voroshkov/Solo-DIY-RF-Laptimer/(threads)

Thread 4 (2017-01-16):

Question

Freakshowdevil, 2017-01-16:
A quick question, Is it possible to have all the channels selectable via the app, is it a Arduino limitation or is the code not complete?
Nice work man :1st_place_medal:  ordering all part now and looking forward to the Multi-tracking Laptimer solution. How far have you come? How many RX5808 should I order :) and are you using Arduino Pro Mini for this one as well?

voroshkov, 2017-01-16:
Yes, it's possible to make all bands/channels selectable. I intentionally limited them to simplify the app.

As for the multi-version: it will use the same hardware with minor modifications. My idea is to make the "Solo" devices attachable to each other to track several pilots during a race. Each racer may have his own fully functional device to track his solo flights, but when flying with friends, they just plug their laptimers like **A**->**B**->**C**.. -> **Bluetooth** and use the same hardware & software.
So far the Arduino code for the multi- version is complete and real Android app (not the AppInventor) is capable of communicating via bluetooth :)

voroshkov, 2017-01-16:
So for the multi- solution you need solo- hardware multiplied by the number of devices you'd like to make :)

Freakshowdevil, 2017-01-16:
That is brilliant, I am so excited about this 👍
I'm ordering everything times 3.
Great if all band and channels are selectable, because some of my friends uses vtx that dont have raceband.

Super work, you're a king mate 👑

voroshkov, 2017-01-16:
Thanks for the feedback!

Freakshowdevil, 2017-01-16:
An idea for the start race. When you hitt start on the app the laptimer should wait 10 seconds before it starts tracking, the last 5 seconds of the wait timer the buzzer should beep each second and one long beep when race starts (start countdown).
And another thing is to set max lap count and long buzzer beep when max lap is reached for all quads. Then you don't have to count in your head when flying 😁

Just some ideas

voroshkov, 2017-01-18:
Thanks for the ideas. However they are likely to be implemented in a next generation app :)

Freakshowdevil, 2017-01-26:
Which pin number do you use to connect more RF-Laptimers together, so I can prepare this on my timers that I build.

voroshkov, 2017-01-31:
So far my idea is to make it like this:
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

Thread 5 (2017-01-17):

BaudRate for HC06

jreis1, 2017-01-17:
Just a quick note, it seems that for some HC06 Bluetooth modules the pre defined 115200baud doesn't work.  This value must be altered to 9600baud.

Great job here mate!

voroshkov, 2017-01-17:
I think all HC-06 BT modules may pre-tuned to communicate at 115200 using "AT+BAUD8" command (as seen here, for example: https://www.youtube.com/watch?v=jSxcEZHsV0A).

9600 will slow down the communication and make the Android app less responsive, I guess.

brkdwn, 2017-01-19:
Just fyi I also had to programm the HC-06 to 115200. Now everything is working fine. Thanks for the help.

voroshkov, 2017-01-20:
Updated Readme with simplified BT module setup steps.

Freakshowdevil, 2017-01-22:
Can't get the BT to communicate to Pro mini. In app when connected it only shows S>>> Flashing nothing more? I have the baud rate set to 115200. And one more thing, how do I easily check if my pro-mini is a 5V or 3.3V? I believe that I received the wrong one (3.3V) and that's my problem.

Freakshowdevil, 2017-01-23:
Found the problem, my arduino is 3.3v 8MHz 😪

Thread 6 (2017-01-20):

channels

plastinaf, 2017-01-20:
Hello
Good work and thank you for sharing
I modified the channels.h tab.
To activate the channel and frequency F / Airwave because me and many people don't have raceBand
----------------------------------------------
// Channels to send to the SPI registers
const uint16_t channelTable[] PROGMEM = {
    // Channel 1 - 8
    // 0x281D, 0x288F, 0x2902, 0x2914, 0x2987, 0x2999, 0x2A0C, 0x2A1E // Raceband
    // 0x2A05, 0x299B, 0x2991, 0x2987, 0x291D, 0x2913, 0x2909, 0x289F // Band A
    // 0x2903, 0x290C, 0x2916, 0x291F, 0x2989, 0x2992, 0x299C, 0x2A05 // Band B
    // 0x2895, 0x288B, 0x2881, 0x2817, 0x2A0F, 0x2A19, 0x2A83, 0x2A8D // Band E
     0x2906, 0x2910, 0x291A, 0x2984, 0x298E, 0x2998, 0x2A02, 0x2A0C // Band F / Airwave
    // 0x2609, 0x261C, 0x268E, 0x2701, 0x2713, 0x2786, 0x2798, 0x280B // Band D / 5.3
};
// Channels' MHz Values
const uint16_t channelFreqTable[] PROGMEM = {
    // Channel 1 - 8
    // 5658, 5695, 5732, 5769, 5806, 5843, 5880, 5917 // Raceband
    // 5865, 5845, 5825, 5805, 5785, 5765, 5745, 5725 // Band A
    // 5733, 5752, 5771, 5790, 5809, 5828, 5847, 5866 // Band B
    // 5705, 5685, 5665, 5645, 5885, 5905, 5925, 5945 // Band E
     5740, 5760, 5780, 5800, 5820, 5840, 5860, 5880 // Band F / Airwave
    // 5362, 5399, 5436, 5473, 5510, 5547, 5584, 5621 // Band D / 5.3
};
-----------------------------------------------
And upload
But this does not work
Other modification?
Thank you

voroshkov, 2017-01-20:
Can you specify what exactly doesn't work?
Does the Android app show Current RSSI value?
Does this value change when you change channels in the app?
Does it change when you change channels on VTX?

jreis1, 2017-01-20:
it is not enough to alter the arduino code to have all other bands. I also need to prepare the android app so   it can be suitable for all other freq. bands. I believe it is what is happening here.

voroshkov, 2017-01-20:
@jreis1, not quite so. Android app in this project is just a user interface to the Arduino-driven device. You may close the app anytime during the race, but once you re-launch it and reconnect, it will pick up current state from the device and display as if it was continuously running.

In ordrer to change the band you don't need anything except commenting/uncommenting the corresponding line in the ```channelTable``` (even the ``channelFreqTable``` should not be changed, because it isn't used in code at all).

plastinaf, 2017-01-21:
Hi Andrey
OK I explain
Does the Android app show Current RSSI value?
= yes but value not change or very little i have 880-885 when VTX is off.
   and when VTX is on, No change 880-885 in all channel.
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

I added a 4.7k resistor in the rssi line and Ground
Now the value is around 250 - 330 when VTX is Off.
And 600 - 800 when VTX is on but not change if i select other channel  1 - 8 in the APP
It work on Band F in solo but if other guy emit in 5.8 Ghz the counter increase because detect other VTX
Voila !
sorry for my bad anglish i translate with Google

voroshkov, 2017-01-21:
The RSSI values you mention are too high. Normally RX5808 produces RSSI voltage from 0.5 to 1.5V, which corresponds to digital values in range from 100 to 300 on 5V Arduino.
RSSI reading of 880 corresponds to ~4.3V, which is definitely too high.

I think you should either verify your schematic or replace the RX module and make sure to apply the SPI patch to it.

Freakshowdevil, 2017-01-21:
sheaivey/rx5808-pro-diversity uses a 100k resistor between RSSI and ground and 1k resistor on each SPI, why aren't we using it here?

voroshkov, 2017-01-21:
SPI communication is not extensive in this project. SPI is only used upon changing channel, so I found it not necessary to add resistors on SPI lines, though [mentioned](https://github.com/voroshkov/Solo-DIY-RF-Laptimer#wiring) that it might make sense.

As for 100k to ground on RSSI line - I'm not sure what it would be needed for (but I'm not so experienced in electronics and open to improvements)

Thread 7 (2017-01-29):

serial

driekes1984, 2017-01-29:
Keep getting 'Serial' was not declared in this scope
Why?

#define TO_HEX(i) (i <= 9 ? 0x30 + i : 0x41 + i - 10)

void halfByteToHex(uint8_t *buf, uint8_t val) {
    buf[0] = TO_HEX((val & 0x0F));
}
void byteToHex(uint8_t *buf, uint8_t val) {
    halfByteToHex(buf, val >> 4);
    halfByteToHex(&buf[1], val);
}
void intToHex(uint8_t *buf, uint16_t val) {
    byteToHex(buf, val >> 8);
    byteToHex(&buf[2], val & 0x00FF);
}
void longToHex(uint8_t *buf, uint32_t val) {
    intToHex(buf, val >> 16);
    intToHex(&buf[4], val & 0x0000FFFF);
}

uint8_t send4BitsToSerial(uint8_t prefix, uint8_t byteValue) {
    if (Serial.availableForWrite() >= 3) {
        Serial.write(prefix);
        uint8_t buf;
        halfByteToHex(&buf, byteValue);
        Serial.write(buf);
        Serial.write('\n');
        return(1);
    }
    return(0);
}

uint8_t sendByteToSerial(uint8_t prefix, uint8_t byteValue) {
    if (Serial.availableForWrite() >= 4) {
        Serial.write(prefix);
        uint8_t buf[2];
        byteToHex(buf, byteValue);
        Serial.write(buf, 2);
        Serial.write('\n');
        return(1);
    }
    return(0);
}

uint8_t sendIntToSerial(uint8_t prefix, uint16_t intValue) {
    if (Serial.availableForWrite() >= 6) {
        Serial.write(prefix);
        uint8_t buf[4];
        intToHex(buf, intValue);
        Serial.write(buf, 4);
        Serial.write('\n');
        return(1);
    }
    return(0);
}

uint8_t sendLongToSerial(uint8_t prefix, uint8_t counter, uint32_t longValue) {
    if (Serial.availableForWrite() >= 12) {
        Serial.write(prefix);
        uint8_t buf[8];
        byteToHex(buf, counter);
        Serial.write(buf, 2);
        longToHex(buf, longValue);
        Serial.write(buf, 8);
        Serial.write('\n');
        return(1);
    }
    return(0);
}

voroshkov, 2017-01-30:
Maybe you're trying to compile this file as a standalone one?
In my project it's included in .ino, where Serial is defined.

driekes1984, 2017-01-30:
No i am jusing the .ino to complile.

I am a real newbie at this so  im sorry if i sound stupid.

voroshkov, 2017-01-30:
What version of Arduino IDE do you use?

driekes1984, 2017-01-30:
I believe 1.6.4

voroshkov, 2017-01-30:
1. Download repository
2. Unzip to temp folder
3. Go to .../Solo-DIY-RF-Laptimer-master/Arduino/solo-diy-rf-laptimer
4. Open solo-diy-rf-laptimer.ino with Arduino IDE
5. In IDE select Tools -> Board -> "Arduino Pro or Pro Mini" (if you use this board, of course)
6. Select Tools -> Processor -> "Atmega328 (5V 16MHz)"
7. Select Sketch -> Verify/Compile
Done. Without any compilation issues.

driekes1984, 2017-01-30:
Ok ill try that thanx

driekes1984, 2017-01-30:
I updated my IDE to 1.8.1 now it works thank you very mutch

voroshkov, 2017-01-30:
I have 1.6.7. which also works fine.
I guess your previous Arduino installation was corrupted somehow.

driekes1984, 2017-01-30:
Yeh maby but thanks anyway i realy like this build

Closed 2017-01-30.

Thread 8 (2017-02-05):

Android apps

2black0, 2017-02-05:
Hi, I get issue with android apps, please check attach file

It not show what channel used, rssi is not show

2black0, 2017-02-05:
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

data flow change rapidly from R>> to S<<, and bytes received is about 0 or 2

2black0, 2017-02-05:
FYI :
I use pro mini + HC05 (Baud 115200) + RX5808(V1.0)
original source code (no editing)

2black0, 2017-02-05:
and try press - / + in channel and get this

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

voroshkov, 2017-02-05:
It all looks like a baud rate issue. Screenshot shows that Android app reads some trash instead of meaningful HEX values from BT.
Please verify that you use:
- 5V 16MHz Arduino
- 115200 baud at BT module (e.g. try to connect to it from PC via USB-UART adapter at the specified baudrate)

2black0, 2017-02-06:
For hc05 baudrate I can confirm 115200 (will post screenshot later)

For arduino need to be check again, okay I will report here asap after make check

2black0, 2017-02-06:
I change promini with UNO (5v + 16Mhz), and this is screenshot of baudrate changed of hc05

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

2black0, 2017-02-06:
the problem still same, android apps still not show value like before

voroshkov, 2017-02-06:
The terminal screenshot shows that you successfully communicate with your BT module at 9600 baud (see lower right corner of the terminal window). I'm not sure why it shows 115200 as a response.

2black0, 2017-02-06:
sorry for not info the process, I use softserial (uno) to connected with HC05, cause I dont have FTDI, but it works, If I send AT it will respond OK, so I think AT Command work normally

voroshkov, 2017-02-06:
I see. OK. What is the code you use on Arduino to communicate with HC05?

2black0, 2017-02-06:
////////////////////////////////////////////////////////////////////////////////////////////////////////////////////

#include <SoftwareSerial.h>

SoftwareSerial mySerial(10, 11); // RX, TX

void setup() {

Serial.begin(9600);

pinMode(9,OUTPUT); digitalWrite(9,HIGH);

Serial.println("Enter AT commands:");

mySerial.begin(38400);

}

void loop()

{

if (mySerial.available())

Serial.write(mySerial.read());

if (Serial.available())

mySerial.write(Serial.read());

}

/////////////////////////////////////////////////////////////////////////////////////////////////////////////////////////

I am following this tutorial : http://www.instructables.com/id/AT-command-mode-of-HC-05-Bluetooth-module/step4/Setting-up-connection/

voroshkov, 2017-02-06:
OK. ```mySerial.begin(38400);``` means that BT module is connected to Arduino at 38400.

voroshkov, 2017-02-06:
Did you enter "AT+BAUD8" command in terminal?

voroshkov, 2017-02-06:
Sorry, I've never worked with HC-05 before. It looks like in config mode it's always 38400.
Take a look at this vid: https://www.youtube.com/watch?v=zoJUAjW3vQ0
It looks they enter a bit different command to set baud rate:  AT+UART=115200**,1,**0

2black0, 2017-02-06:
Okay thanks, will try with AT+UART=115200,1,0
Will report here asap

voroshkov, 2017-02-06:
Well, it looks this won't work. These params control the parity and stop bits. Two zeros correspond to default Arduino UART settings.
One more thing you might need is a voltage divider at RX pin of your BT module(to have 3.3V signals instead of 5V), but this seems odd, since you can successfully communicate with HC05 during setup without a voltage divider.

2black0, 2017-02-06:
Wait I will make simple test of BT HC05 and Arduino (BT Terminal), if this is a problem maybe I need to fix it first, but If no problem I think the side of Android APPs maybe have some bug,

Oh, my test device is Xiaomi RedMi Note 4 (MIUI 8),

nikybiasion, 2017-02-06:
I use HC-05 without issues, set to 115200 and all works great

2black0, 2017-02-06:
@nikybiasion AT+UART=115200,1,0 right?

nikybiasion, 2017-02-06:
i've set only AT+UART=115200, try to reset the module with AT+ORGL, set name, password and speed

voroshkov, 2017-02-09:
@2black0 have you managed to solve the issue?

2black0, 2017-02-09:
@voroshkov still cant solved, I am still trying with other bluetooth, maybe this one is not normal

voroshkov, 2017-02-09:
You can try a simple test:
1. connect your HC05 to arduino:
- GND - GND
- 5V - VCC
- RX - TX
- TX - RX
2. Upload sketch:
```
int cnt = 0;
void setup() {
   Serial.begin(115200);
}
void loop() {
   cnt++;
   Serial.print("Counter:");
   Serial.println(cnt);
   delay(1000);
}
```
3. Download https://play.google.com/store/apps/details?id=Qwerty.BluetoothTerminal to your phone
4. Power all up and connect from phone App to BT

If after connection you see messages "Counter: X" appearing in android app, then it's all set up correctly and there's possibly an issue with Solo Laptimer App or with hardware connections in your laptimer device.

Otherwise, try changing the baud rate in the Serial.begin(115200); line of the sketch. So you'll find out what baud rate your HC module really uses.

2black0, 2017-02-09:
@voroshkov will try this night, will reported it back

FredFrancisIT, 2017-03-10:
Any update on this one ?

leveltgn, 2017-08-25:
from my youtube chanel (Spanish, sorry)

Adaptador TTL
solo cuatro cables necesarios; RX, TX, +5V y GND
(TX-RX cruzados)
Hay que conseguir entrar en el modo AT2 (pulsar el boton al conectar al TTL y soltar) parpadeo de led 1/seg
Ventana de comandos a 38400 baudios (Ambos NL & CR)
Introducimos:
AT+UART=115200,1,0
AT+NAME=NOMBRE
el pin será 1234
Con esa configuración funcionan perfectamente
Partir siempre de la configuración original

Thread 9 (2017-02-06):

How to connect to raspberry

nikybiasion, 2017-02-06:
I see that i need to use easyracelaptimer 0.6 and raspberry pi 3. I suppose i've to connect pin 5 from arduino to the GPIO pin as described in easyracelaptimer vtx_sensor docs.
But, arduino works at 5v and raspberry at 3,3v. I need a voltage divider? Arduino and Raspberry need to share the same GND? I'm not an expert electronic :)

voroshkov, 2017-02-06:
I did it like this (used some N-type MOSFET which opens at less than 5V).
Also you may use 3.3V to 5V logic level converter, but in this case Arduino code should be changed to generate a pulse of inverted polarity.

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

voroshkov, 2017-02-06:
Also here's the visual reference to Raspberry Pin numbers.
ERLT uses pins:
- gpio25: 'VTX_1' - pin 37
- gpio24: 'VTX_2' - pin 35
- gpio23: 'VTX_3' - pin 33
- gpio22: 'VTX_4' - pin 31
- gpio21: 'VTX_5' - pin 29
- gpio3:  'VTX_6' - pin 15
- gpio2:  'VTX_7' - pin 13
- gpio0:  'VTX_8' - pin 11

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

R91g, 2017-02-10:
> I see that i need to use easyracelaptimer 0.6 and raspberry pi 3. I suppose i've to connect pin 5 from arduino to the GPIO pin as described in easyracelaptimer vtx_sensor docs.
But, arduino works at 5v and raspberry at 3,3v. I need a voltage divider? Arduino and Raspberry need to share the same GND? I'm not an expert electronic :)

I don't understand.
Raspberry works at 5v, you don't need any voltage dividir, you can power Raspberry and Arduino from the same 5v.

voroshkov, 2017-02-10:
Raspberry is powered from 5V, but GPIO levels are 3.3V.
The question was about connecting Solo laptimer device to Raspberry GPIO to use it as a VTX sensor for Easy Race Lap Timer software.

R91g, 2017-02-10:
Yes, me too I want connect Solo Laptimer Device to Raspberry Pi with Easy Race Timer.
I I believed that only need to connect Arduino Pin 5 to GPIO 37, and also power the raspberry Pi and Arduino from a baterry at 5v

R91g, 2017-02-11:
Another question.

Can we use a Arduino Pro Mini 3.3v 8Mhz?
Are 8Mhz enough for run this code properly?

voroshkov, 2017-02-11:
> Can we use a Arduino Pro Mini 3.3v 8Mhz?
Are 8Mhz enough for run this code properly?

I think there's nothing in code which depends on board frequency, but I didn't try. Also timing accuracy will suffer a bit.

>With this arduino we can connect pin 5 to Raspberry Pi directly. In this case we can't power RX5808 from arduino, but we can power it from Raspberry Pi GPIO 5v.

But in this case I'm not sure RX5808 will correctly interpret SPI signals from Arduino.

shamshir1972, 2017-03-02:
voroshkov, may i know N type mosfet parts number that u use. I've no idea what parts number to buy

voroshkov, 2017-03-02:
I got mine from old laptop motherboard. You can use any "logical" mosfet, e.g. BSS138 or powerful IRF630.

FranzAr, 2017-03-12:
So I think, this is clear so far. But I still have to use the app to set band/channel, Threshold and minimum lap time. Is this correct or can/could it be done via EasyRacelapTimer software?

voroshkov, 2017-03-13:
Yes, you have to maintain 2 connections (wired to Raspberry, and bluetooth to configure).
I didn't investigate the possibility to use ERLT for configuration, and don't plan it so far.
If anyone's ready to spend time for investigation, I'll eagerly help with explanation of communication protocol.

asficas, 2017-03-14:
Voroshkov You have done an excellent job! Thank you!
I built a twin solo chorus and we raced one on one in the car park and it worked really well!
I am now looking at easyracelaptimer pocket edition serial protocol and will try to connect the two solos to raspi3 ERLT. I will let you know if I make any progress.
Thanks again from Athens Greece.

voroshkov, 2017-03-14:
Cool! Thanks!

shamshir1972, 2017-03-20:
voroshkov, i've already setup voltage divider using IRF630 as u suggested but i cannot get any rssi value at erlt racebox webpage. Is it i've to configure anything ? i'm using 0.6 image file, pls help me

voroshkov, 2017-03-20:
You won't get any RSSI value in ERLT. You need to setup device via Bluetooth and then start race in ERLT. ERLT will just capture time when RSSI is higher than threshold (when drone passes the laptimer).

shamshir1972, 2017-03-20:
ok i got it working, i've already set threshold via bluetooth b4, but in pilot name under token id i've to set as 'VTX_1' instead of "VTX_SENSOR_1" to make erlt triggered the lap

voroshkov, 2017-03-20:
can you specify what is bluetooth b4?

Thread 12 (2019-09-23):

Compiling error

teopbako, 2019-09-23:
Tried to Compile before uploading and i got this msg:
Arduino: 1.8.10 (Windows 7), Πλακέτα:"Arduino Pro or Pro Mini, ATmega328P (5V, 16 MHz)"

C:\Users\User\Desktop\Arduino\solo-diy-rf-laptimer\solo-diy-rf-laptimer.ino:270:10: warning: missing terminating ' character

     <!-- '"` --><!-- </textarea></xmp> --></option></form><form class="js-site-search-form" role="search" aria-label="Site" data-scope-type="Repository" data-scope-id="77248892" data-scoped-search-url="/voroshkov/Solo-DIY-RF-Laptimer/search" data-unscoped-search-url="/search" action="/voroshkov/Solo-DIY-RF-Laptimer/search" accept-charset="UTF-8" method="get"><input name="utf8" type="hidden" value="&#x2713;" />

          ^

solo-diy-rf-laptimer:270:10: error: missing terminating ' character

     <!-- '"` --><!-- </textarea></xmp> --></option></form><form class="js-site-search-form" role="search" aria-label="Site" data-scope-type="Repository" data-scope-id="77248892" data-scoped-search-url="/voroshkov/Solo-DIY-RF-Laptimer/search" data-unscoped-search-url="/search" action="/voroshkov/Solo-DIY-RF-Laptimer/search" accept-charset="UTF-8" method="get"><input name="utf8" type="hidden" value="&#x2713;" />

          ^~~~~~~~~~~~~~~~~~~~~~~~~~~~~~~~~~~~~~~~~~~~~~~~~~~~~~~~~~~~~~~~~~~~~~~~~~~~~~~~~~~~~~~~~~~~~~~~~~~~~~~~~~~~~~~~~~~~~~~~~~~~~~~~~~~~~~~~~~~~~~~~~~~~~~~~~~~~~~~~~~~~~~~~~~~~~~~~~~~~~~~~~~~~~~~~~~~~~~~~~~~~~~~~~~~~~~~~~~~~~~~~~~~~~~~~~~~~~~~~~~~~~~~~~~~~~~~~~~~~~~~~~~~~~~~~~~~~~~~~~~~~~~~~~~~~~~~~~~~~~~~~~~~~~~~~~~~~~~~~~~~~~~~~~~~~~~~~~~~~~~~~~~~~~~~~~~~~~~~~~~~~~~~~~~~~~~~~~~~~~~~~~~~~~~~~~~~~~~~~~~~~

solo-diy-rf-laptimer:316:75: error: stray '\342' in program

       <span aria-hidden="true" class="d-inline-block ml-1 v-align-middle">↵</span>

                                                                           ^

solo-diy-rf-laptimer:316:76: error: stray '\206' in program

       <span aria-hidden="true" class="d-inline-block ml-1 v-align-middle">↵</span>

                                                                            ^

solo-diy-rf-laptimer:316:77: error: stray '\265' in program

       <span aria-hidden="true" class="d-inline-block ml-1 v-align-middle">↵</span>

                                                                             ^

solo-diy-rf-laptimer:321:56: error: stray '\342' in program

       <span class="d-inline-block ml-1 v-align-middle">↵</span>

                                                        ^

solo-diy-rf-laptimer:321:57: error: stray '\206' in program

       <span class="d-inline-block ml-1 v-align-middle">↵</span>

                                                         ^

solo-diy-rf-laptimer:321:58: error: stray '\265' in program

       <span class="d-inline-block ml-1 v-align-middle">↵</span>

                                                          ^

solo-diy-rf-laptimer:357:75: error: stray '\342' in program

       <span aria-hidden="true" class="d-inline-block ml-1 v-align-middle">↵</span>

                                                                           ^

solo-diy-rf-laptimer:357:76: error: stray '\206' in program

       <span aria-hidden="true" class="d-inline-block ml-1 v-align-middle">↵</span>

                                                                            ^

solo-diy-rf-laptimer:357:77: error: stray '\265' in program

       <span aria-hidden="true" class="d-inline-block ml-1 v-align-middle">↵</span>

                                                                             ^

solo-diy-rf-laptimer:362:56: error: stray '\342' in program

       <span class="d-inline-block ml-1 v-align-middle">↵</span>

                                                        ^

solo-diy-rf-laptimer:362:57: error: stray '\206' in program

       <span class="d-inline-block ml-1 v-align-middle">↵</span>

                                                         ^

solo-diy-rf-laptimer:362:58: error: stray '\265' in program

       <span class="d-inline-block ml-1 v-align-middle">↵</span>

                                                          ^

solo-diy-rf-laptimer:389:75: error: stray '\342' in program

       <span aria-hidden="true" class="d-inline-block ml-1 v-align-middle">↵</span>

                                                                           ^

solo-diy-rf-laptimer:389:76: error: stray '\206' in program

       <span aria-hidden="true" class="d-inline-block ml-1 v-align-middle">↵</span>

                                                                            ^

solo-diy-rf-laptimer:389:77: error: stray '\265' in program

       <span aria-hidden="true" class="d-inline-block ml-1 v-align-middle">↵</span>

                                                                             ^

solo-diy-rf-laptimer:394:56: error: stray '\342' in program

       <span class="d-inline-block ml-1 v-align-middle">↵</span>

                                                        ^

solo-diy-rf-laptimer:394:57: error: stray '\206' in program

       <span class="d-inline-block ml-1 v-align-middle">↵</span>

                                                         ^

solo-diy-rf-laptimer:394:58: error: stray '\265' in program

       <span class="d-inline-block ml-1 v-align-middle">↵</span>

                                                          ^

C:\Users\User\Desktop\Arduino\solo-diy-rf-laptimer\solo-diy-rf-laptimer.ino:619:16: warning: missing terminating ' character

           <!-- '"` --><!-- </textarea></xmp> --></option></form><form action="/prompt_dismissals/signup" accept-charset="UTF-8" method="post"><input name="utf8" type="hidden" value="&#x2713;" /><input type="hidden" name="_method" value="put" /><input type="hidden" name="authenticity_token" value="i/XNB72rE1BWMa4roujH4brq7f0xWe5xixXOfV8jL8MN+YgKO4+QOexk9gl2UgttHwJ9g6lNkyYiSNt23PirSg==" />

                ^

solo-diy-rf-laptimer:619:16: error: missing terminating ' character

           <!-- '"` --><!-- </textarea></xmp> --></option></form><form action="/prompt_dismissals/signup" accept-charset="UTF-8" method="post"><input name="utf8" type="hidden" value="&#x2713;" /><input type="hidden" name="_method" value="put" /><input type="hidden" name="authenticity_token" value="i/XNB72rE1BWMa4roujH4brq7f0xWe5xixXOfV8jL8MN+YgKO4+QOexk9gl2UgttHwJ9g6lNkyYiSNt23PirSg==" />

                ^~~~~~~~~~~~~~~~~~~~~~~~~~~~~~~~~~~~~~~~~~~~~~~~~~~~~~~~~~~~~~~~~~~~~~~~~~~~~~~~~~~~~~~~~~~~~~~~~~~~~~~~~~~~~~~~~~~~~~~~~~~~~~~~~~~~~~~~~~~~~~~~~~~~~~~~~~~~~~~~~~~~~~~~~~~~~~~~~~~~~~~~~~~~~~~~~~~~~~~~~~~~~~~~~~~~~~~~~~~~~~~~~~~~~~~~~~~~~~~~~~~~~~~~~~~~~~~~~~~~~~~~~~~~~~~~~~~~~~~~~~~~~~~~~~~~~~~~~~~~~~~~~~~~~~~~~~~~~~~~~~~~~~~~~~~~~~~~~~~~~~~~~~~~~~~~~~~~~~~~~~~~~~~~~~~~~~~

C:\Users\User\Desktop\Arduino\solo-diy-rf-laptimer\solo-diy-rf-laptimer.ino:687:41: warning: missing terminating " character

               <a data-pjax="true" title="merge dev to master (#1)

                                         ^

solo-diy-rf-laptimer:687:41: error: missing terminating " character

               <a data-pjax="true" title="merge dev to master (#1)

                                         ^~~~~~~~~~~~~~~~~~~~~~~~~

C:\Users\User\Desktop\Arduino\solo-diy-rf-laptimer\solo-diy-rf-laptimer.ino:691:116: warning: missing terminating " character

 add readme" class="link-gray" href="/voroshkov/Solo-DIY-RF-Laptimer/commit/a538c42b2c6feb92cd755e9e41856cf6f2a8e1ec">)</a>

                                                                                                                    ^

solo-diy-rf-laptimer:691:116: error: missing terminating " character

 add readme" class="link-gray" href="/voroshkov/Solo-DIY-RF-Laptimer/commit/a538c42b2c6feb92cd755e9e41856cf6f2a8e1ec">)</a>

                                                                                                                    ^~~~~~~

solo-diy-rf-laptimer:902:70: error: stray '#' in program

         <td id="LC32" class="blob-code blob-code-inner js-file-line">#<span class="pl-k">ifdef</span> DEBUG</td>

                                                                      ^

solo-diy-rf-laptimer:906:74: error: stray '#' in program

         <td id="LC33" class="blob-code blob-code-inner js-file-line">    #<span class="pl-k">define</span> <span class="pl-en">DEBUG_CODE</span>(<span class="pl-v">x</span>) <span class="pl-k">do</span> { x } <span class="pl-k">while</span>(<span class="pl-c1">0</span>)</td>

                                                                          ^

solo-diy-rf-laptimer:910:70: error: stray '#' in program

         <td id="LC34" class="blob-code blob-code-inner js-file-line">#<span class="pl-k">else</span></td>

                                                                      ^

solo-diy-rf-laptimer:914:74: error: stray '#' in program

         <td id="LC35" class="blob-code blob-code-inner js-file-line">    #<span class="pl-k">define</span> <span class="pl-en">DEBUG_CODE</span>(<span class="pl-v">x</span>) <span class="pl-k">do</span> { } <span class="pl-k">while</span>(<span class="pl-c1">0</span>)</td>

                                                                          ^

solo-diy-rf-laptimer:918:70: error: stray '#' in program

         <td id="LC36" class="blob-code blob-code-inner js-file-line">#<span class="pl-k">endif</span></td>

                                                                      ^

solo-diy-rf-laptimer:927:70: error: stray '#' in program

         <td id="LC38" class="blob-code blob-code-inner js-file-line">#<span class="pl-k">include</span> <span class="pl-s"><span class="pl-pds">&lt;</span>avr/pgmspace.h<span class="pl-pds">&gt;</span></span></td>

                                                                      ^

solo-diy-rf-laptimer:931:70: error: stray '#' in program

         <td id="LC39" class="blob-code blob-code-inner js-file-line">#<span class="pl-k">include</span> <span class="pl-s"><span class="pl-pds">&quot;</span>fastReadWrite.h<span class="pl-pds">&quot;</span></span></td>

                                                                      ^

solo-diy-rf-laptimer:935:70: error: stray '#' in program

         <td id="LC40" class="blob-code blob-code-inner js-file-line">#<span class="pl-k">include</span> <span class="pl-s"><span class="pl-pds">&quot;</span>fastADC.h<span class="pl-pds">&quot;</span></span></td>

                                                                      ^

solo-diy-rf-laptimer:939:70: error: stray '#' in program

         <td id="LC41" class="blob-code blob-code-inner js-file-line">#<span class="pl-k">include</span> <span class="pl-s"><span class="pl-pds">&quot;</span>pinAssignments.h<span class="pl-pds">&quot;</span></span></td>

                                                                      ^

solo-diy-rf-laptimer:943:70: error: stray '#' in program

         <td id="LC42" class="blob-code blob-code-inner js-file-line">#<span class="pl-k">include</span> <span class="pl-s"><span class="pl-pds">&quot;</span>channels.h<span class="pl-pds">&quot;</span></span></td>

                                                                      ^

solo-diy-rf-laptimer:947:70: error: stray '#' in program

         <td id="LC43" class="blob-code blob-code-inner js-file-line">#<span class="pl-k">include</span> <span class="pl-s"><span class="pl-pds">&quot;</span>sendSerialHex.h<span class="pl-pds">&quot;</span></span></td>

                                                                      ^

solo-diy-rf-laptimer:951:70: error: stray '#' in program

         <td id="LC44" class="blob-code blob-code-inner js-file-line">#<span class="pl-k">include</span> <span class="pl-s"><span class="pl-pds">&quot;</span>rx5808spi.h<span class="pl-pds">&quot;</span></span></td>

                                                                      ^

solo-diy-rf-laptimer:955:70: error: stray '#' in program

         <td id="LC45" class="blob-code blob-code-inner js-file-line">#<span class="pl-k">include</span> <span class="pl-s"><span class="pl-pds">&quot;</span>sounds.h<span class="pl-pds">&quot;</span></span></td>

                                                                      ^

solo-diy-rf-laptimer:964:70: error: stray '#' in program

         <td id="LC47" class="blob-code blob-code-inner js-file-line">#<span class="pl-k">define</span> <span class="pl-en">BAUDRATE</span> <span class="pl-c1">115200</span></td>

                                                                      ^

solo-diy-rf-laptimer:986:70: error: stray '#' in program

         <td id="LC52" class="blob-code blob-code-inner js-file-line">#<span class="pl-k">define</span> <span class="pl-en">MIN_TUNE_TIME</span> <span class="pl-c1">25</span></td>

                                                                      ^

solo-diy-rf-laptimer:1011:70: error: stray '#' in program

         <td id="LC58" class="blob-code blob-code-inner js-file-line">#<span class="pl-k">define</span> <span class="pl-en">RSSI_READS</span> <span class="pl-c1">5</span> <span class="pl-c"><span class="pl-c">//</span> 5 should give about 10 000 readings per second</span></td>

                                                                      ^

solo-diy-rf-laptimer:1024:70: error: stray '#' in program

         <td id="LC61" class="blob-code blob-code-inner js-file-line">#<span class="pl-k">define</span> <span class="pl-en">CONTROL_START_RACE</span> <span class="pl-c1">1</span></td>

                                                                      ^

solo-diy-rf-laptimer:1028:70: error: stray '#' in program

         <td id="LC62" class="blob-code blob-code-inner js-file-line">#<span class="pl-k">define</span> <span class="pl-en">CONTROL_END_RACE</span> <span class="pl-c1">2</span></td>

                                                                      ^

solo-diy-rf-laptimer:1032:70: error: stray '#' in program

         <td id="LC63" class="blob-code blob-code-inner js-file-line">#<span class="pl-k">define</span> <span class="pl-en">CONTROL_DEC_MIN_LAP</span> <span class="pl-c1">3</span></td>

                                                                      ^

solo-diy-rf-laptimer:1036:70: error: stray '#' in program

         <td id="LC64" class="blob-code blob-code-inner js-file-line">#<span class="pl-k">define</span> <span class="pl-en">CONTROL_INC_MIN_LAP</span> <span class="pl-c1">4</span></td>

                                                                      ^

solo-diy-rf-laptimer:1040:70: error: stray '#' in program

         <td id="LC65" class="blob-code blob-code-inner js-file-line">#<span class="pl-k">define</span> <span class="pl-en">CONTROL_DEC_CHANNEL</span> <span class="pl-c1">5</span></td>

                                                                      ^

solo-diy-rf-laptimer:1044:70: error: stray '#' in program

         <td id="LC66" class="blob-code blob-code-inner js-file-line">#<span class="pl-k">define</span> <span class="pl-en">CONTROL_INC_CHANNEL</span> <span class="pl-c1">6</span></td>

                                                                      ^

solo-diy-rf-laptimer:1048:70: error: stray '#' in program

         <td id="LC67" class="blob-code blob-code-inner js-file-line">#<span class="pl-k">define</span> <span class="pl-en">CONTROL_DEC_THRESHOLD</span> <span class="pl-c1">7</span></td>

                                                                      ^

solo-diy-rf-laptimer:1052:70: error: stray '#' in program

         <td id="LC68" class="blob-code blob-code-inner js-file-line">#<span class="pl-k">define</span> <span class="pl-en">CONTROL_INC_THRESHOLD</span> <span class="pl-c1">8</span></td>

                                                                      ^

solo-diy-rf-laptimer:1056:70: error: stray '#' in program

         <td id="LC69" class="blob-code blob-code-inner js-file-line">#<span class="pl-k">define</span> <span class="pl-en">CONTROL_SET_THRESHOLD</span> <span class="pl-c1">9</span></td>

                                                                      ^

solo-diy-rf-laptimer:1060:70: error: stray '#' in program

         <td id="LC70" class="blob-code blob-code-inner js-file-line">#<span class="pl-k">define</span> <span class="pl-en">CONTROL_DATA_REQUEST</span> <span class="pl-c1">255</span></td>

                                                                      ^

solo-diy-rf-laptimer:1073:70: error: stray '#' in program

         <td id="LC73" class="blob-code blob-code-inner js-file-line">#<span class="pl-k">define</span> <span class="pl-en">FILTER_ITERATIONS</span> <span class="pl-c1">5</span></td>

                                                                      ^

solo-diy-rf-laptimer:1094:70: error: stray '#' in program

         <td id="LC78" class="blob-code blob-code-inner js-file-line">#<span class="pl-k">define</span> <span class="pl-en">RSSI_MAX</span> <span class="pl-c1">1024</span></td>

                                                                      ^

solo-diy-rf-laptimer:1098:70: error: stray '#' in program

         <td id="LC79" class="blob-code blob-code-inner js-file-line">#<span class="pl-k">define</span> <span class="pl-en">RSSI_MIN</span> <span class="pl-c1">0</span></td>

                                                                      ^

solo-diy-rf-laptimer:1102:70: error: stray '#' in program

         <td id="LC80" class="blob-code blob-code-inner js-file-line">#<span class="pl-k">define</span> <span class="pl-en">MAGIC_THRESHOLD_REDUCE_CONSTANT</span> <span class="pl-c1">2</span></td>

                                                                      ^

solo-diy-rf-laptimer:1106:70: error: stray '#' in program

         <td id="LC81" class="blob-code blob-code-inner js-file-line">#<span class="pl-k">define</span> <span class="pl-en">THRESHOLD_ARRAY_SIZE</span>  <span class="pl-c1">100</span></td>

                                                                      ^

solo-diy-rf-laptimer:1127:70: error: stray '#' in program

         <td id="LC86" class="blob-code blob-code-inner js-file-line">#<span class="pl-k">define</span> <span class="pl-en">MIN_MIN_LAP_TIME</span> <span class="pl-c1">1</span> <span class="pl-c"><span class="pl-c">//</span>seconds</span></td>

                                                                      ^

solo-diy-rf-laptimer:1131:70: error: stray '#' in program

         <td id="LC87" class="blob-code blob-code-inner js-file-line">#<span class="pl-k">define</span> <span class="pl-en">MAX_MIN_LAP_TIME</span> <span class="pl-c1">60</span> <span class="pl-c"><span class="pl-c">//</span>seconds</span></td>

                                                                      ^

solo-diy-rf-laptimer:1139:70: error: stray '#' in program

         <td id="LC89" class="blob-code blob-code-inner js-file-line">#<span class="pl-k">define</span> <span class="pl-en">MAX_LAPS</span> <span class="pl-c1">100</span></td>

                                                                      ^

solo-diy-rf-laptimer:1516:203: error: stray '#' in program

         <td id="LC180" class="blob-code blob-code-inner js-file-line">                <span class="pl-k">if</span> (<span class="pl-c1">send4BitsToSerial</span>(<span class="pl-s"><span class="pl-pds">&#39;</span>C<span class="pl-pds">&#39;</span></span>, channelIndex)) {</td>

                                                                                                                                                                                                           ^

solo-diy-rf-laptimer:1516:237: error: stray '#' in program

         <td id="LC180" class="blob-code blob-code-inner js-file-line">                <span class="pl-k">if</span> (<span class="pl-c1">send4BitsToSerial</span>(<span class="pl-s"><span class="pl-pds">&#39;</span>C<span class="pl-pds">&#39;</span></span>, channelIndex)) {</td>

                                                                                                                                                                                                                                             ^

solo-diy-rf-laptimer:1536:203: error: stray '#' in program

         <td id="LC185" class="blob-code blob-code-inner js-file-line">                <span class="pl-k">if</span> (<span class="pl-c1">send4BitsToSerial</span>(<span class="pl-s"><span class="pl-pds">&#39;</span>R<span class="pl-pds">&#39;</span></span>, isRaceStarted)) {</td>

                                                                                                                                                                                                           ^

solo-diy-rf-laptimer:1536:237: error: stray '#' in program

         <td id="LC185" class="blob-code blob-code-inner js-file-line">                <span class="pl-k">if</span> (<span class="pl-c1">send4BitsToSerial</span>(<span class="pl-s"><span class="pl-pds">&#39;</span>R<span class="pl-pds">&#39;</span></span>, isRaceStarted)) {</td>

                                                                                                                                                                                                                                             ^

solo-diy-rf-laptimer:1556:202: error: stray '#' in program

         <td id="LC190" class="blob-code blob-code-inner js-file-line">                <span class="pl-k">if</span> (<span class="pl-c1">sendByteToSerial</span>(<span class="pl-s"><span class="pl-pds">&#39;</span>M<span class="pl-pds">&#39;</span></span>, minLapTime)) {</td>

                                                                                                                                                                                                          ^

solo-diy-rf-laptimer:1556:236: error: stray '#' in program

         <td id="LC190" class="blob-code blob-code-inner js-file-line">                <span class="pl-k">if</span> (<span class="pl-c1">sendByteToSerial</span>(<span class="pl-s"><span class="pl-pds">&#39;</span>M<span class="pl-pds">&#39;</span></span>, minLapTime)) {</td>

                                                                                                                                                                                                                                            ^

solo-diy-rf-laptimer:1576:201: error: stray '#' in program

         <td id="LC195" class="blob-code blob-code-inner js-file-line">                <span class="pl-k">if</span> (<span class="pl-c1">sendIntToSerial</span>(<span class="pl-s"><span class="pl-pds">&#39;</span>T<span class="pl-pds">&#39;</span></span>, rssiThreshold)) {</td>

                                                                                                                                                                                                         ^

solo-diy-rf-laptimer:1576:235: error: stray '#' in program

         <td id="LC195" class="blob-code blob-code-inner js-file-line">                <span class="pl-k">if</span> (<span class="pl-c1">sendIntToSerial</span>(<span class="pl-s"><span class="pl-pds">&#39;</span>T<span class="pl-pds">&#39;</span></span>, rssiThreshold)) {</td>

                                                                                                                                                                                                                                           ^

solo-diy-rf-laptimer:1596:201: error: stray '#' in program

         <td id="LC200" class="blob-code blob-code-inner js-file-line">                <span class="pl-k">if</span> (<span class="pl-c1">sendIntToSerial</span>(<span class="pl-s"><span class="pl-pds">&#39;</span>S<span class="pl-pds">&#39;</span></span>, rssi)) {</td>

                                                                                                                                                                                                         ^

solo-diy-rf-laptimer:1596:235: error: stray '#' in program

         <td id="LC200" class="blob-code blob-code-inner js-file-line">                <span class="pl-k">if</span> (<span class="pl-c1">sendIntToSerial</span>(<span class="pl-s"><span class="pl-pds">&#39;</span>S<span class="pl-pds">&#39;</span></span>, rssi)) {</td>

                                                                                                                                                                                                                                           ^

solo-diy-rf-laptimer:1620:206: error: stray '#' in program

         <td id="LC206" class="blob-code blob-code-inner js-file-line">                    <span class="pl-k">if</span> (<span class="pl-c1">sendLongToSerial</span>(<span class="pl-s"><span class="pl-pds">&#39;</span>L<span class="pl-pds">&#39;</span></span>, sendLapTimesIndex, lapTimes[sendLapTimesIndex])) {</td>

                                                                                                                                                                                                              ^

solo-diy-rf-laptimer:1620:240: error: stray '#' in program

         <td id="LC206" class="blob-code blob-code-inner js-file-line">                    <span class="pl-k">if</span> (<span class="pl-c1">sendLongToSerial</span>(<span class="pl-s"><span class="pl-pds">&#39;</span>L<span class="pl-pds">&#39;</span></span>, sendLapTimesIndex, lapTimes[sendLapTimesIndex])) {</td>

                                                                                                                                                                                                                                                ^

C:\Users\User\Desktop\Arduino\solo-diy-rf-laptimer\solo-diy-rf-laptimer.ino:2449:12: warning: missing terminating ' character

       <!-- '"` --><!-- </textarea></xmp> --></option></form><form class="js-jump-to-line-form Box-body d-flex" action="" accept-charset="UTF-8" method="get"><input name="utf8" type="hidden" value="&#x2713;" />

            ^

solo-diy-rf-laptimer:2449:12: error: missing terminating ' character

       <!-- '"` --><!-- </textarea></xmp> --></option></form><form class="js-jump-to-line-form Box-body d-flex" action="" accept-charset="UTF-8" method="get"><input name="utf8" type="hidden" value="&#x2713;" />

            ^~~~~~~~~~~~~~~~~~~~~~~~~~~~~~~~~~~~~~~~~~~~~~~~~~~~~~~~~~~~~~~~~~~~~~~~~~~~~~~~~~~~~~~~~~~~~~~~~~~~~~~~~~~~~~~~~~~~~~~~~~~~~~~~~~~~~~~~~~~~~~~~~~~~~~~~~~~~~~~~~~~~~~~~~~~~~~~~~~~~~~~~~~~~~~~~~~~~~~

solo-diy-rf-laptimer:2503:12: error: stray '\342' in program

     You can’t perform that action at this time.

            ^

solo-diy-rf-laptimer:2503:13: error: stray '\200' in program

     You can’t perform that action at this time.

             ^

solo-diy-rf-laptimer:2503:14: error: stray '\231' in program

     You can’t perform that action at this time.

              ^

solo-diy-rf-laptimer:7:1: error: expected unqualified-id before '<' token

 <!DOCTYPE html>

 ^

solo-diy-rf-laptimer:142:25: error: 'up' does not name a type; did you mean 'u8'?

               Sign&nbsp;up

                         ^~

                         u8

solo-diy-rf-laptimer:169:267: error: expected unqualified-id before '<' token

                     <a href="/features" class="py-2 lh-condensed-ultra d-block link-gray-dark no-underline h5 Bump-link--hover" data-ga-click="(Logged out) Header, go to Features">Features <span class="Bump-link-symbol float-right text-normal text-gray-light">&rarr;</span></a>

                                                                                                                                                                                                                                                                           ^

solo-diy-rf-laptimer:186:332: error: expected unqualified-id before '<' token

                       <li class="edge-item-fix"><a href="/customer-stories" class="py-2 lh-condensed-ultra d-block no-underline link-gray-dark no-underline h5 Bump-link--hover" data-ga-click="(Logged out) Header, go to Customer stories">Customer stories <span class="Bump-link-symbol float-right text-normal text-gray-light">&rarr;</span></a></li>

                                                                                                                                                                                                                                                                                                                                            ^

solo-diy-rf-laptimer:187:308: error: expected unqualified-id before '<' token

                       <li class="edge-item-fix"><a href="/security" class="py-2 lh-condensed-ultra d-block no-underline link-gray-dark no-underline h5 Bump-link--hover" data-ga-click="(Logged out) Header, go to Security">Security <span class="Bump-link-symbol float-right text-normal text-gray-light">&rarr;</span></a></li>

                                                                                                                                                                                                                                                                                                                    ^

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
